jpwolfe31/10-Character-7x5-Luminator-Flip-Dot-Display/IMG_2178.JPG

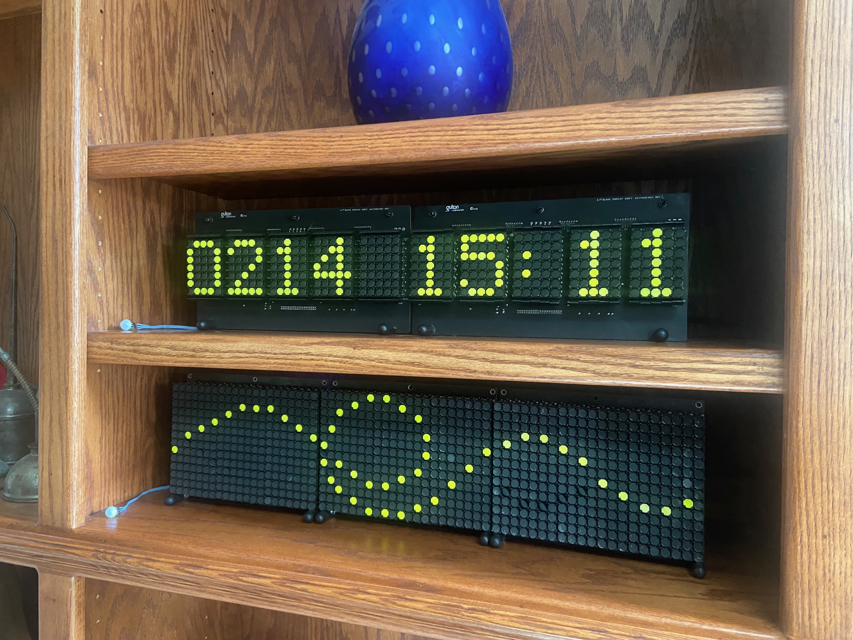
IMG_2178.JPG
