jpwolfe31/10-Character-7x5-Luminator-Flip-Dot-Display/Luminator 5 char 7by5 display board schematic 2-25-2024.pdf

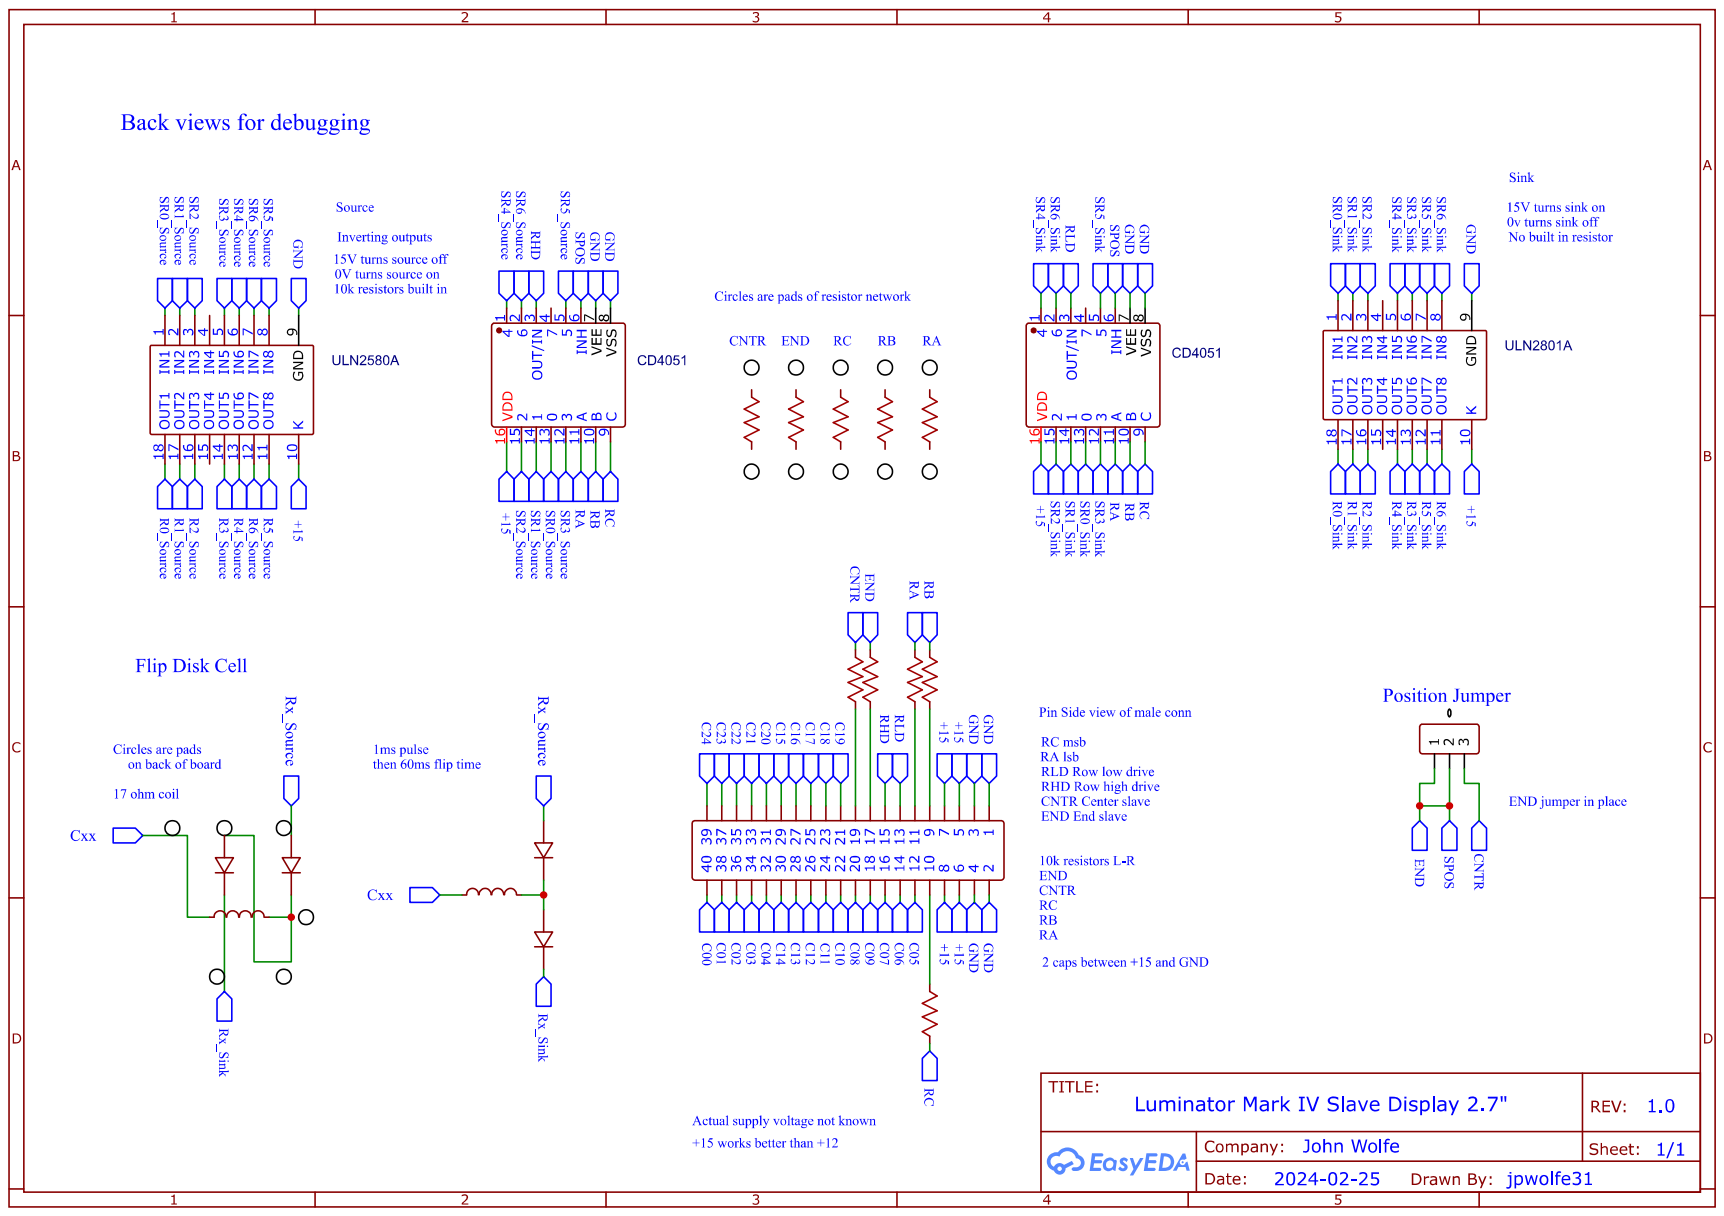
[picture p9: page 1]
