jpwolfe31/10-Character-7x5-Luminator-Flip-Dot-Display/10 character 7by5 schematic page 1.pdf

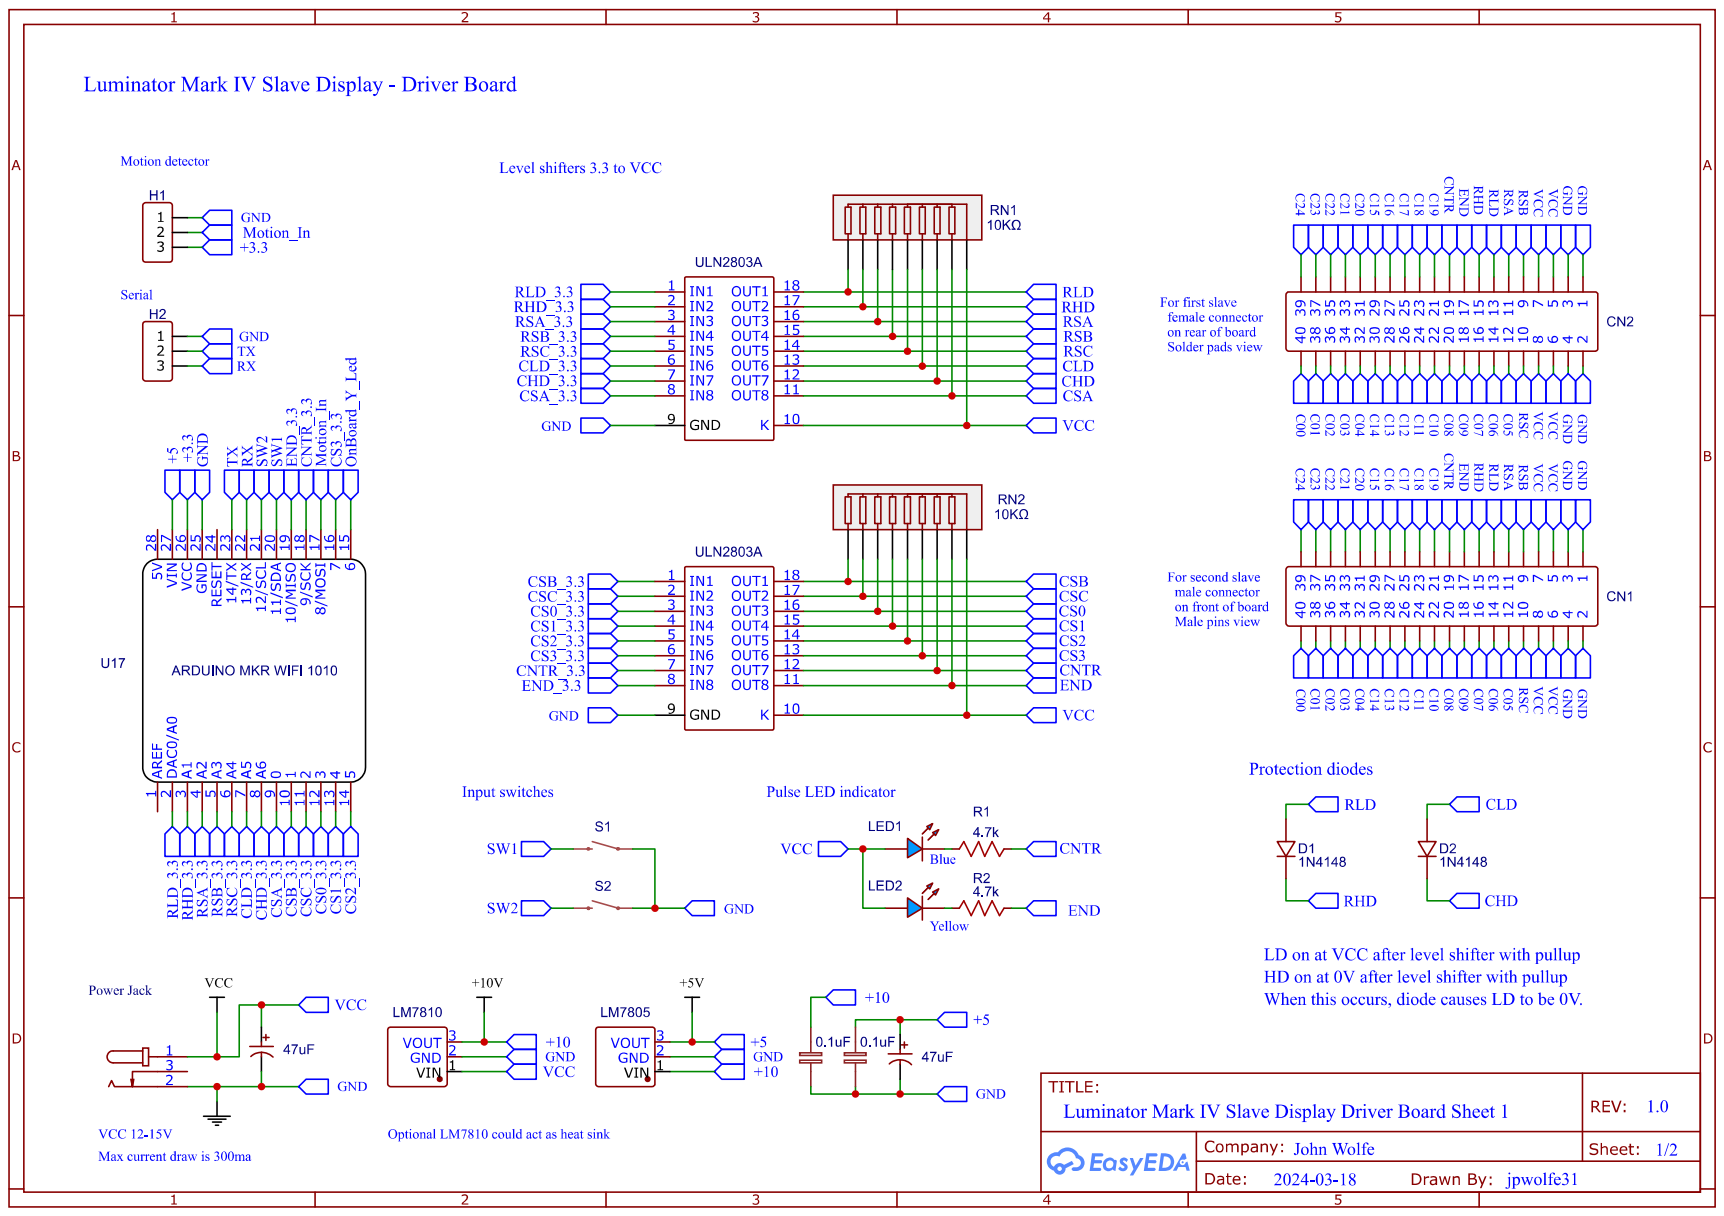
[picture p10: page 1]
