jpwolfe31/10-Character-7x5-Luminator-Flip-Dot-Display/flip_dot_7x50_11_22_2024_uploaded/fonts.ino

// ascii code
// control characters 0-31 plus 127
// printable characters 32-126
const static byte font_data[] = {
  0x55, 0x2A, 0x55, 0x2A, 0x55,  // 0x00 (checker 0) (was ascii nul)
  0x2A, 0x55, 0x2A, 0x55, 0x2A,  // 0x01 (checker 1) (was ascii soh)
  0x00, 0x14, 0x00, 0x00, 0x00,  // 0x02 (left :) (was ascii stx)
  0x00, 0x00, 0x00, 0x14, 0x00,  // 0x03 (right :) (was ascii etx)
  0x18, 0x3C, 0x7E, 0x3C, 0x18,  // 0x04 (eot)
  0x1C, 0x57, 0x7D, 0x57, 0x1C,  // 0x05 (enq)
  0x1C, 0x5E, 0x7F, 0x5E, 0x1C,  // 0x06 (ack)
  0x00, 0x18, 0x3C, 0x18, 0x00,  // 0x07 (bel)
  0xFF, 0xE7, 0xC3, 0xE7, 0xFF,  // 0x08 (bs)
  0x00, 0x18, 0x24, 0x18, 0x00,  // 0x09 (tab)
  0xFF, 0xE7, 0xDB, 0xE7, 0xFF,  // 0x0A (lf)
  0x30, 0x48, 0x3A, 0x06, 0x0E,  // 0x0B (vt)
  0x26, 0x29, 0x79, 0x29, 0x26,  // 0x0C (np)
  0x40, 0x7F, 0x05, 0x05, 0x07,  // 0x0D (cr)
  0x40, 0x7F, 0x05, 0x25, 0x3F,  // 0x0E (so)
  0x5A, 0x3C, 0xE7, 0x3C, 0x5A,  // 0x0F (si)
  0x7F, 0x3E, 0x1C, 0x1C, 0x08,  // 0x10 (dle)
  0x08, 0x1C, 0x1C, 0x3E, 0x7F,  // 0x11 (dc1)
  0x14, 0x22, 0x7F, 0x22, 0x14,  // 0x12 (dc2)
  0x5F, 0x5F, 0x00, 0x5F, 0x5F,  // 0x13 (dc3)
  0x06, 0x09, 0x7F, 0x01, 0x7F,  // 0x14 (dc4)
  0x00, 0x66, 0x89, 0x95, 0x6A,  // 0x15 (nak)
  0x60, 0x60, 0x60, 0x60, 0x60,  // 0x16 (syn)
  0x94, 0xA2, 0xFF, 0xA2, 0x94,  // 0x17 (etb)
  0x08, 0x04, 0x7E, 0x04, 0x08,  // 0x18 (can)
  0x10, 0x20, 0x7E, 0x20, 0x10,  // 0x19 (em)
  0x08, 0x08, 0x2A, 0x1C, 0x08,  // 0x1A (eof)
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
  0x3C, 0x40, 0x40, 0x20, 0x7C,  // 0x75 u
  0x1C, 0x20, 0x40, 0x20, 0x1C,  // 0x76 v
  0x3C, 0x40, 0x30, 0x40, 0x3C,  // 0x77 w
  0x44, 0x28, 0x10, 0x28, 0x44,  // 0x78 x
  0x0C, 0x10, 0x10, 0x10, 0x7C,  // 0x79 y
  0x44, 0x64, 0x54, 0x4C, 0x44,  // 0x7A z
  0x00, 0x08, 0x36, 0x41, 0x00,  // 0x7B {
  0x00, 0x00, 0x77, 0x00, 0x00,  // 0x7C |
  0x00, 0x41, 0x36, 0x08, 0x00,  // 0x7D }
  0x02, 0x01, 0x02, 0x04, 0x02};  // 0x7E ~
  // not included 
  // 0x7F (127) would be ascii DEL (delete)
  // 0s80 (128) to 0xFF (255) are extended ascii used in 1981 IBM PC.

void get_char_fd_array(char char_out)
{
byte char_base_addr;

//Serial.begin(9600); // for serial monitor
//while (!Serial) {}; // wait for serial port to connect.
//Serial.print("Character is: ");
//Serial.println(char_out);

char_base_addr = byte(char_out);
//Serial.print("Hex address is: ");
//Serial.println(char_base_addr, HEX);
//Serial.println();
//Serial.println("Flip disc display shows: ");
//Serial.println();

for (int c = 0; c <= 4; c++){
  for (int r = 0; r <= 6; r++){
    fd_array[c][r] = ((font_data[(char_base_addr * 5) + c]) >> r) & 0x01; //bitwise and
    }  
  }

//for (int r = 0; r <= 6; r++){
//  for (int c = 0; c <=4; c++){
//    Serial.print(fd_array[c][r]);
//    Serial.print("  ");
//    } 
//  Serial.println();
//  }
}



// !"#$%&'()*+,-./:;<=>?@[\]^_`{|}~
